lorebarta/STM32-Respiratory-Rate-Meter/FFT_On_STM32.pdf

# FFT on STM32

# System idea

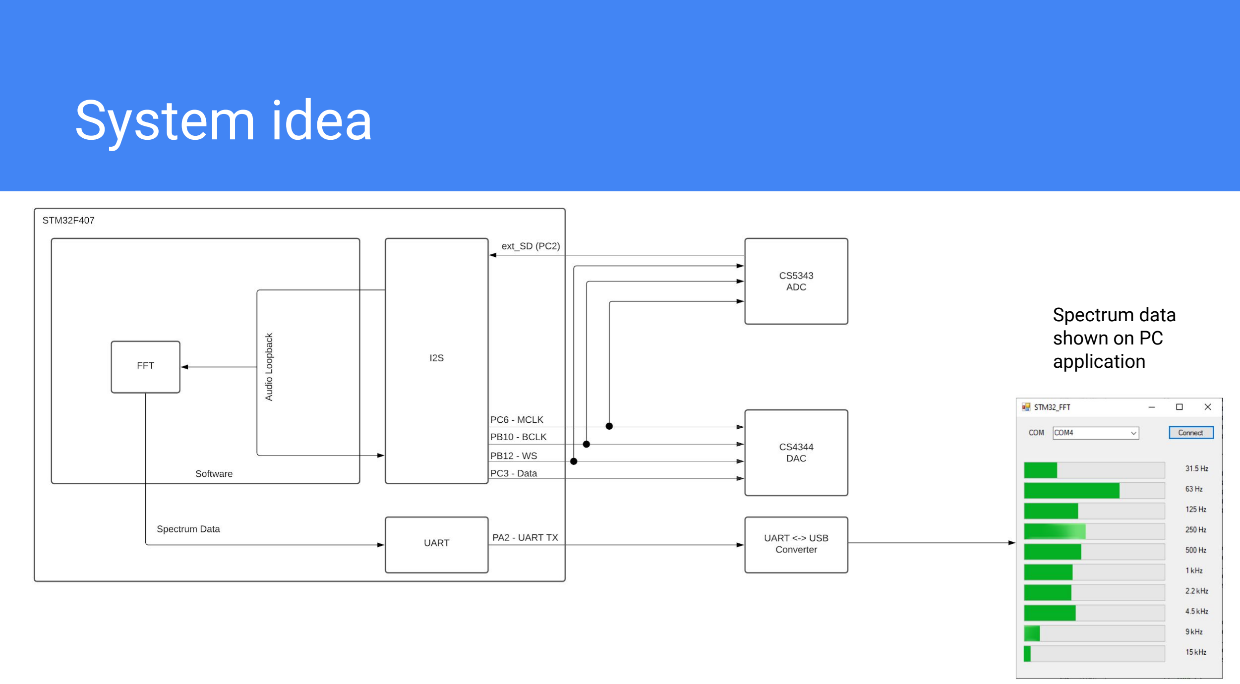
[picture p38: page 2]

Spectrum data
shown on PC
application

# CMSIS DSP Library

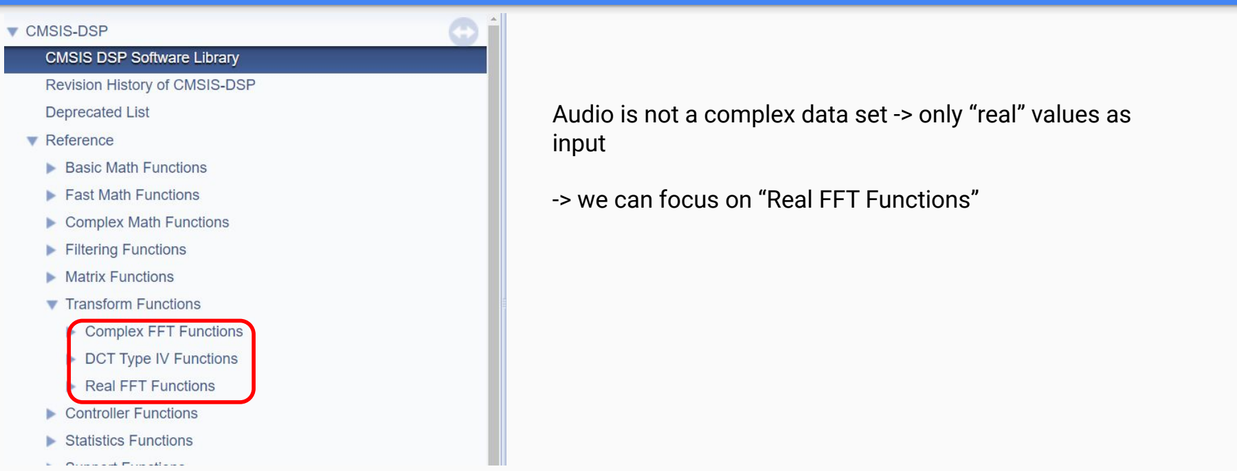
[picture p39: figure]
input; -> we can focus on “Real FFT Functions”

Audio is not a complex data set -> only “real” values as

# arm_rfft_fast_f32

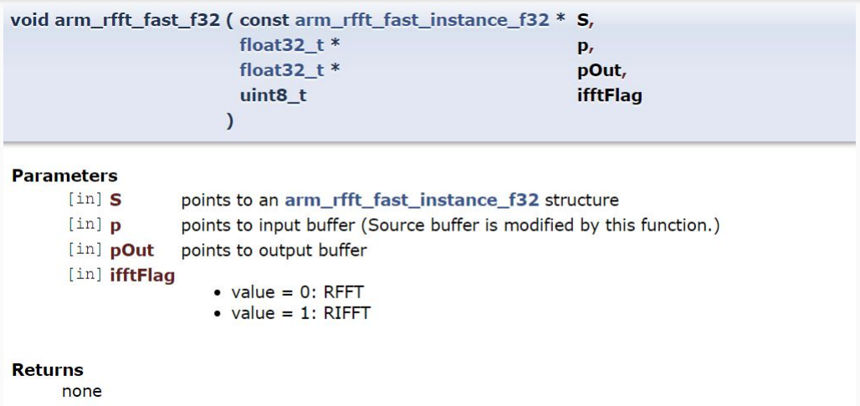
[picture p40: figure]

ifftFlag will be “0” as
we want to do a
forward transform
and not an inverse
one

# FFT input and output

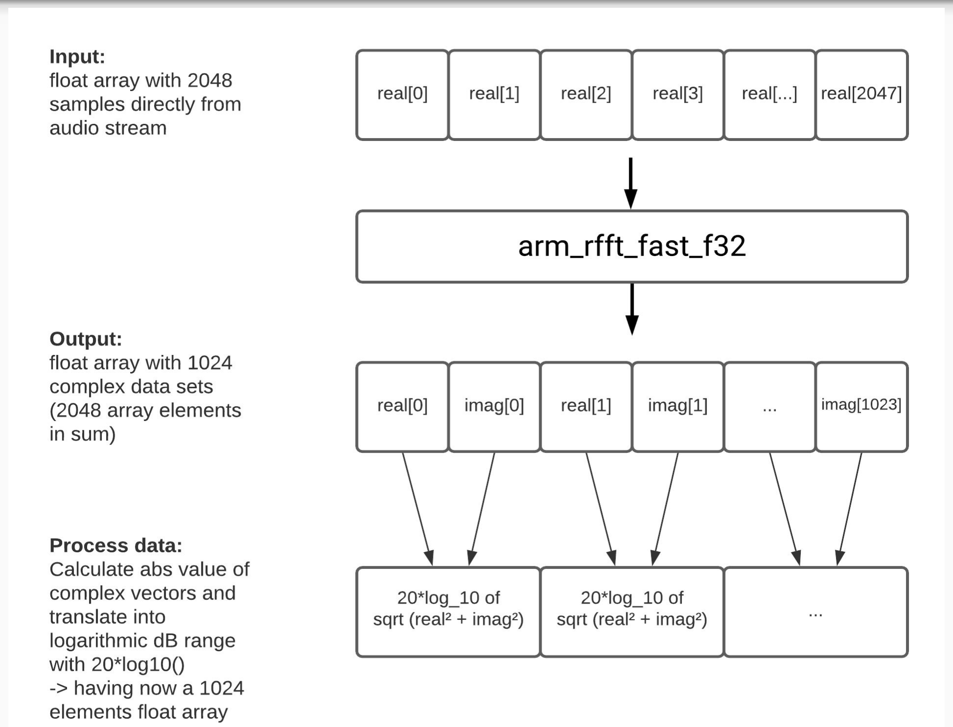
[picture p41: figure]

FFT processing-lengths are always power-of-2 (512, 1024, 2048, 4096, …)

# How to match frequency and array index?

### The spectrum is plotted linear from DC to (f_sample/2) Hz on array-index 0 - 1023

### Example: - f_sample = 48 kHz (actually 46.875 kHz)

- 500 Hz -> 500 * (1024/(46875/2)) = 21.85

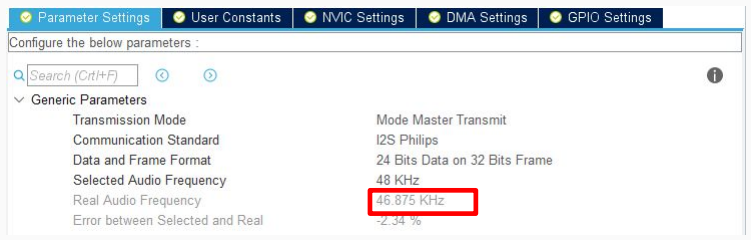
[picture p42: figure]

### -> nearest array-index 22 (503.5 Hz)
