lorebarta/STM32-Respiratory-Rate-Meter/Altium/Sim/switch.asc

D1: schottky
M1: pmos
M2: pmos
R1: res; 10k
V1: voltage; 3.5
V2: voltage; 5
Named nets: 0, out
.tran 5
