lorebarta/STM32-Respiratory-Rate-Meter/Altium/Sim/FDA.asc

C1: cap; 100n
C2: cap; 100n
R1: res; 220k
R2: res; 115k
R3: res; 19k
R4: res; 1k
R5: res; 2900
R6: res; 2900
R7: res; 3200
R8: res; 3200
U2: UniversalOpAmp2
U3: UniversalOpAmp2
V1: voltage; 3.3
V2: voltage; SINE(0 0.1 1k 1 0 0 1k)
Named nets: 0, voltage, vnoise, piu, meno, V+, OUT-, OUT+, V-, EN, IN-, VOCM, IN+
.inc C:\\Users\\loreb\\Downloads\\sboc064c\\OPA1632.LIB
.tran 5
