lorebarta/STM32-Respiratory-Rate-Meter/Altium/Sim/ltc.asc

C1: cap; 10µ
C2: cap; 47p
C3: cap; 20p
C4: cap; 22µ
L1: ind; 4.7µ
R1: res; 280k
R2: res; 887k
U1: LTC3404
V1: voltage; 5
Named nets: 0, Vin, out
.tran 10
