lorebarta/STM32-Respiratory-Rate-Meter/Altium/Sim/BEST.asc

C1: cap; 100n
C2: cap; 100n
R1: res; 2900
R2: res; 3600
R3: res; 1Meg
R4: res; 1Meg
U1: UniversalOpAmp2
U2: UniversalOpAmp2
V1: voltage; 3.3
V2: voltage; SINE(0 0.1 1k 1 0 0 1k)
Named nets: 0, voltage, vin, out, nonfil
.tran 3
