lorebarta/STM32-Respiratory-Rate-Meter/Altium/Sim/Draft3.asc

C1: cap; 10µ
C2: cap; 10µ
R1: res; 10k
R2: res; 10k
R3: res; 15k
R4: res; 1k
R5: res; 2900
R6: res; 2900
R7: res; 3200
R8: res; 3200
U1: OPA1632
U2: UniversalOpAmp2
U3: UniversalOpAmp2
V1: voltage; 3.3
V2: voltage; SINE(0 0.1 1k 1 0 0 1k)
Named nets: Vin-, Vout+, Vout-, V-, EN, Vin+, 0, voltage, vnoise, Vcom, V+, piu, meno
.inc C:\\Users\\loreb\\Downloads\\sboc064c\\OPA1632.LIB
.tran 5
