lorebarta/STM32-Respiratory-Rate-Meter/Altium/Sim/Sim_condizionamento_hs.asc

C1: cap; 1µ
C2: cap; 1µ
C3: cap; 1µ
R1: res; 1k
R2: res; 1k
R3: res; 18k
R4: res; 18k
R5: res; 2000
R6: res; 2000
R7: res; 2900
R8: res; 100k
R9: res; 100k
R10: res; 100k
RBAND: res; 3600
U1: UniversalOpAmp2
U2: UniversalOpAmp2
U7: UniversalOpAmp2
U8: UniversalOpAmp2
V1: voltage; 3.3
V2: voltage; SINE(0 0.1 1k 1 0 0 1k)
Named nets: 0, out, voltage, vnoise, Vnoise, piu, meno, p, m, SKfiltered, RCfilter
.tran 5
