lorebarta/STM32-Respiratory-Rate-Meter/Altium/Sim/Sim_MioCond.asc

C1: cap; 1µ
R1: res; 2900
R2: res; 3000
R3: res; 100k
U1: OP07
V1: voltage; 3.3
V2: voltage; SINE(0 0.1 1000 1 0 0 1meg); AC 1
Named nets: 0, Vpp, out
.tran 10
