lorebarta/STM32-Respiratory-Rate-Meter/(list of files, drawings)

Other design files:
Altium/ChargerSwitch.SchDoc
Altium/Conditioning.SchDoc
Altium/Connectors.SchDoc
Altium/DCDC.SchDoc
Altium/H&S_FreqResp.PrjPcb
Altium/Microcontroller.SchDoc
Altium/PCB_FreqResp.PcbDoc
Altium/PcbLib1.PcbLib
Altium/Schlib1.SchLib
