lorebarta/STM32-Respiratory-Rate-Meter/Frequenza_Respiratoria_Full/Core/Src/main.c

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
/* Includes ------------------------------------------------------------------*/
#include "main.h"

/* USER CODE BEGIN Includes */
//https://www.youtube.com/watch?v=iU9Jb06Fpp4&lc=Ugxi7EpiAMnnVwpu3YF4AaABAg.9wjBtW2wV1w9wmlrlGRIeD
#include <string.h>
#include <stdio.h>
#include "arm_math.h"
/* USER CODE END Includes */

/* USER CODE BEGIN PD */
#define ADC_BUF_LEN 1024          //E' la lunghezza della FFT. Forse va uguale al num di bit dell'ADC?? Cioè 2^12 = 4096
#define SAMPLING_RATE 6000

#define PRINTF 0
/* USER CODE END PD */

ADC_HandleTypeDef hadc1;
DMA_HandleTypeDef hdma_adc1;

UART_HandleTypeDef huart2;

/* USER CODE BEGIN PV */
arm_rfft_fast_instance_f32 fft_audio_instance;
uint16_t adc_in_value[ADC_BUF_LEN];
float adc_in_value_volt[ADC_BUF_LEN];     //"adc_in_value" convertito in volt (tensione)


float32_t input_fft[ADC_BUF_LEN];
float32_t output_fft[ADC_BUF_LEN];
float32_t output_fft_mag[ADC_BUF_LEN / 2];
float32_t frequencies_axis_half_size[ADC_BUF_LEN / 2];
float32_t frequencies_axis[ADC_BUF_LEN / 2];

uint8_t fftIndex = 0;
int i = 0;
volatile uint16_t HalfCpltCallback;    //half_i2s
volatile uint16_t CpltCallback;        //full_i2s

float peakVal = 0.0f;
uint16_t peakHz = 0;
float curVal = 0;
/* USER CODE END PV */

void SystemClock_Config(void);
static void MX_GPIO_Init(void);
static void MX_DMA_Init(void);
static void MX_USART2_UART_Init(void);
static void MX_ADC1_Init(void);
/**
  * @brief  The application entry point.
  * @retval int
  */
int main(void)
{
  /* MCU Configuration--------------------------------------------------------*/

  /* Reset of all peripherals, Initializes the Flash interface and the Systick. */
  HAL_Init();

  /* Configure the system clock */
  SystemClock_Config();

  /* Initialize all configured peripherals */
  MX_GPIO_Init();
  MX_DMA_Init();
  MX_USART2_UART_Init();
  MX_ADC1_Init();
  /* USER CODE BEGIN 2 */
  arm_rfft_fast_init_f32(&fft_audio_instance, ADC_BUF_LEN); //Inizializzo la FFT
  /* USER CODE END 2 */

  /* Infinite loop */
  /* USER CODE BEGIN WHILE */
  while (1)
  {


#if 0
	    int frequency = 1000;
		//generate sinusoidal signal (this is what you receive from outside in the ADC pin, for example)
		HAL_Delay(100);
		for (int i = 0; i < FFT_LENGTH; i++) {
			sine_val[i] = arm_sin_f32(2*PI*frequency*i/SAMPLING_RATE);
			//"sine_val" contains only one frequency (500Hz), so "output_fft" must contain all 0 except a spike at 500Hz
		}
#endif


		HAL_ADC_Start_DMA(&hadc1, (uint32_t*) adc_in_value, ADC_BUF_LEN);
		//aggiungi in basso delle funzioni callback perchè il main.c non sa quando il buffer è pieno (o pieno a metà)

//---------------------------------------------------------------------------------------------
		if (CpltCallback == 1) {      //full buffer riempito


		HAL_GPIO_WritePin(GPIOD, GPIO_PIN_15, GPIO_PIN_SET);


		for (i = 0; i < ADC_BUF_LEN; i++) {
		adc_in_value_volt[i] = ((float)(adc_in_value[i])*3/4096);
		//printf("adc_in_value[%d] = %d\n", i, adc_in_value[i]);
		//printf("adc_in_value_volt[%d]: %f\n", i, adc_in_value_volt[i]);
		}


		//"output_fft" contiene: frequency values and phase informations.
		//E' formato da complex numbers:
		//- in posizione pari ci sono i numeri reali
		//- in posizione dispari c'è la parte immaginary del numero complesso.
		//Perciò, "output_fft" = [a0, b0, a1, b1, a2, b2, .. , a(N/2)-1, b(N/2)-] = a0+ib0, a1+ib1, a2+ib2 ..
		//..in cui a0,a1,a2 etc. sono la parte reale mentre b0,b1,b2 etc. sono la parte immaginaria del numero complesso.
		//Quindi se "adc_in_value_volt" input a sta funzione ha "ADC_BUF_LEN" elementi,
		//..allora "output_fft" in output avrà sempre dimensione "ADC_BUF_LEN", ma conterrà "ADC_BUF_LEN / 2" numeri complessi al suo interno .. dato che come ho detto è così: a0+ib0, a1+ib1, a2+ib2 ..
		arm_rfft_fast_f32(&fft_audio_instance, adc_in_value_volt, output_fft, 0);

		//ORA HO CALCOLATO LA FFT DI "adc_in_value_volt", RICORDA CHE CONTIENE SOLO "ADC_BUF_LEN" ELEMENTI!


		//estraggo magnitude perchè ci interessa quella .. non ci interessa la fase!
		//Estrai da "output_fft" la magnitude che è, per forza, metà fft (cioè FFT_LENGTH/2).
		//Quindi, sapendo che "output_fft" = [a0, b0, a1, b1, a2, b2, ..] = a0+ib0, a1+ib1, a2+ib2 ..
		//ottieni "output_fft_mag" = [c0, c1, c2 .. ] con c0 = sqrt(a0^2+b0^2), c1 = sqrt(a1^2+b1^2), c2 = sqrt(a2^2+b2^2)

		/*
		//1° Metodo per estrarre magnitude:
		arm_cmplx_mag_f32(output_fft, (float32_t*)output_fft_mag, ADC_BUF_LEN/2);
		output_fft_mag[0] = 0; //bias
		for (i = 0; i < ADC_BUF_LEN / 2; i++) {
			frequencies_axis[i] = ((i * SAMPLING_RATE) / ADC_BUF_LEN);
			printf("i = %d   frequency %f: %f \n", i, frequencies_axis[i], output_fft_mag[i]);
			//printf("frequency %f \n", frequencies_axis[i]);
			//HAL_UART_Transmit(&huart1, (uint16_t*)(frequencies_axis_str[i]), FFT_LENGTH / 2, HAL_MAX_DELAY);
			//HAL_Delay(5);
		}*/



		//2° Metodo per estrarre magnitude:
		uint16_t freqIndex = 0;
		for (uint16_t index = 0; index < ADC_BUF_LEN; index += 2) {

			curVal = sqrtf((output_fft[index] * output_fft[index]) + (output_fft[index+1] * output_fft[index+1]));                                                                                                  //k

			if (curVal > peakVal) {
				peakVal = curVal;
				peakHz = (uint16_t) (freqIndex * SAMPLING_RATE / ((float)ADC_BUF_LEN));
			}
			freqIndex++;
		}

	printf("peakHz = %f \n", peakVal);





CpltCallback = 0;

HAL_GPIO_WritePin(GPIOD, GPIO_PIN_15, GPIO_PIN_RESET);
}	//fine CpltCallback == 1
//---------------------------------------------------------------------------------------------


#if 0
		//"output_fft" contiene: frequency values and phase informations.
		//E' formato da complex numbers:
		//- in posizione pari ci sono i numeri reali
		//- in posizione dispari c'è la parte immaginary del numero complesso.
		//Perciò, "output_fft" = [a0, b0, a1, b1, a2, b2, .. , a(N/2)-1, b(N/2)-] = a0+ib0, a1+ib1, a2+ib2 ..
		//..in cui a0,a1,a2 etc. sono la parte reale mentre b0,b1,b2 etc. sono la parte immaginaria del numero complesso.
		//Quindi se "adc_in_value_volt" input a sta funzione ha "ADC_BUF_LEN" elementi,
		//..allora "output_fft" in output avrà sempre dimensione "ADC_BUF_LEN", ma conterrà "ADC_BUF_LEN / 2" numeri complessi al suo interno .. dato che come ho detto è così: a0+ib0, a1+ib1, a2+ib2 ..
		arm_rfft_fast_f32(&fft_audio_instance, adc_in_value_volt, output_fft, 0);
		/*for (i = 0; i < ADC_BUF_LEN; i++) {
		printf("output_fft[%d]: %f\n", i, output_fft[i]);
		}*/


		//estraggo magnitude perchè ci interessa quella .. non ci interessa la fase!
		//Estrai da "output_fft" la magnitude che è, per forza, metà fft (cioè FFT_LENGTH/2).
		//Quindi, sapendo che "output_fft" = [a0, b0, a1, b1, a2, b2, ..] = a0+ib0, a1+ib1, a2+ib2 ..
		//ottieni "output_fft_mag" = [c0, c1, c2 .. ] con c0 = sqrt(a0^2+b0^2), c1 = sqrt(a1^2+b1^2), c2 = sqrt(a2^2+b2^2)

				//1° Metodo per estrarre magnitude:
		//arm_cmplx_mag_f32(output_fft, (float32_t*)output_fft_mag, ADC_BUF_LEN/2);
		//output_fft_mag[0] = 0; //bias
		for (i = 0; i < ADC_BUF_LEN / 2; i++) {
				frequencies_axis[i] = ((i * SAMPLING_RATE) / ADC_BUF_LEN);
				printf("i = %d   frequency %f: %f \n", i, frequencies_axis[i], output_fft_mag[i]);
				//printf("frequency %f \n", frequencies_axis[i]);
				//HAL_UART_Transmit(&huart1, (uint16_t*)(frequencies_axis_str[i]), FFT_LENGTH / 2, HAL_MAX_DELAY);
				//HAL_Delay(5);
			}

				//2° Metodo per estrarre magnitude:
		uint16_t freqIndex = 0;
		for (uint16_t index = 0; index < ADC_BUF_LEN; index += 2) {

			curVal = sqrtf((output_fft[index] * output_fft[index]) + (output_fft[index+1] * output_fft[index+1]));                                                                                                  //k

			if (curVal > peakVal) {
				peakVal = curVal;
				peakHz = (uint16_t) (freqIndex * SAMPLING_RATE / ((float)ADC_BUF_LEN));
			}
			freqIndex++;
		}
#endif

		/*for (i = 0; i < ADC_BUF_LEN; i++) {
			frequencies_axis[i] = ((i * SAMPLING_RATE) / ADC_BUF_LEN);
			printf("i = %d   frequency %f: %f \n", i, frequencies_axis[i], output_fft_mag[i]);
			//printf("frequency %f \n", frequencies_axis[i]);
			//HAL_UART_Transmit(&huart1, (uint16_t*)(frequencies_axis_str[i]), FFT_LENGTH / 2, HAL_MAX_DELAY);
			//HAL_Delay(5);
		}*/















#if 0
	  HAL_GPIO_WritePin(GPIOD, GPIO_PIN_15, GPIO_PIN_SET); //inizio, start timing

	  //Get ADC values:
	  HAL_ADC_Start_DMA(&hadc1, adc_in_value, sizeof(adc_in_value));
	  HAL_ADC_PollForConversion(&hadc1, HAL_MAX_DELAY);  //Poll for regular conversion complete .. il processore si blocca finchè non viene fatta conversione adc                         k
	  adc_in_value = HAL_ADC_GetValue(&hadc1);
	  tensione = adc_in_value*3/4095.0;

	  	  for (int i = 0; i < SAMPLES; i++) {
	  		  vReal[i] = tensione; // Converti il valore letto in tensione (0-3V) e convertilo in double
	  		  vImag[i] = 0;            // Imposta la parte immaginaria a zero (nel tuo caso)

	  		  HAL_Delay(1000 / SAMPLING_FREQUENCY);  //delay = 1s / SAMPLING_FREQUENCY
	  	  }
#endif


	  // Applica la finestra di Hamming ai dati
	  //FFT.Windowing(vReal, SAMPLES, FFT_WIN_TYP_HAMMING, FFT_FORWARD);

	  // Esegui la FFT
	  //FFT.Compute(vReal, vImag, SAMPLES, FFT_FORWARD);

	  // Trova la frequenza massima
	  //double peak = FFT.MajorPeak();


	  //sprintf(adc_in_str, "hu\r\n", adc_in_value); //converto "adc_in" in stringa per stamparlo
	  //HAL_UART_Transmit(&huart2, (uint8_t*)adc_in_str, strlen(adc_in_str), HAL_MAX_DELAY);



    /* USER CODE END WHILE */

    /* USER CODE BEGIN 3 */
  }
  /* USER CODE END 3 */
}

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
/* USER CODE BEGIN 4 */



//Callback quando la prima metà del buffer è riempita/piena
void HAL_ADC_ConvHalfCpltCallback(ADC_HandleTypeDef* hadc) {

	//HAL_GPIO_WritePin(GPIOD, GPIO_PIN_15, GPIO_PIN_SET);
	HalfCpltCallback = 1;

}



void HAL_ADC_ConvCpltCallback(ADC_HandleTypeDef* hadc) {

	//HAL_GPIO_WritePin(GPIOD, GPIO_PIN_15, GPIO_PIN_RESET);
	CpltCallback = 1;

}



/* USER CODE END 4 */
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
