lorebarta/STM32-Respiratory-Rate-Meter/(notices)

Notices in the files:
Frequenza_Respiratoria_Full/Core/Inc/main.h:
Copyright (c) 2023 STMicroelectronics.
All rights reserved.
This software is licensed under terms that can be found in the LICENSE file
